UncommonModels/FemtoLCC/site/content/docs/_index.md

---
title: "Documentation"
---

Reference material for building, ordering and reproducing the FemtoLCC board.
