UncommonModels/FemtoLCC/production/render-bottom.png

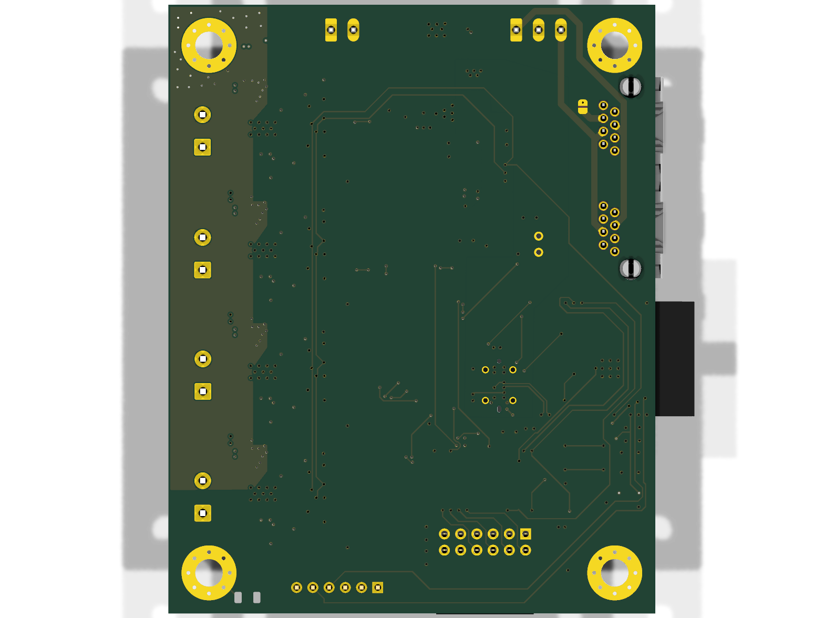
production/render-bottom.png
