UncommonModels/FemtoLCC/project_libraries/RJHSE508002/RJHSE508002.step

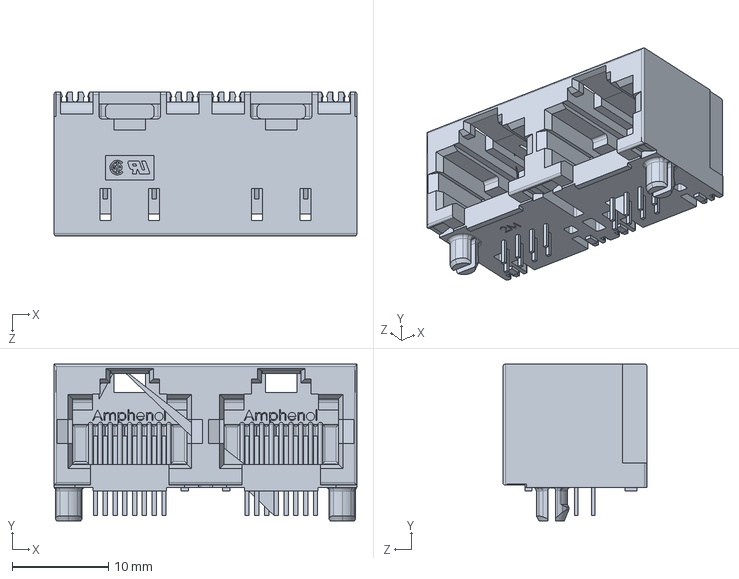
[picture p3: CAD file, 2026-04-15]
project_libraries/RJHSE508002/RJHSE508002.step
31.5 x 16.3 x 15.0 mm
