UncommonModels/FemtoLCC/project_libraries/ul_DRV8874PWPR/KiCADv6/PWP0016A.stp

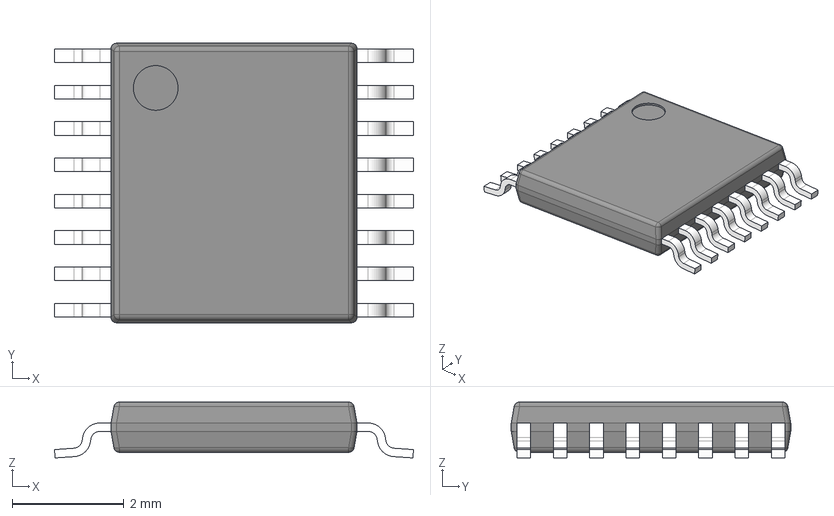
[picture p4: CAD file, 2025-12-02]
project_libraries/ul_DRV8874PWPR/KiCADv6/PWP0016A.stp
6.42 x 5.00 x 1.00 mm
BODY-SO
LEAD-SO x 16
THERMALPAD-SO
PIN1-ID
