UncommonModels/FemtoLCC/FemtoLCC.kicad_pcb

## KiCad design FemtoLCC.kicad_pcb (2026-09-06)

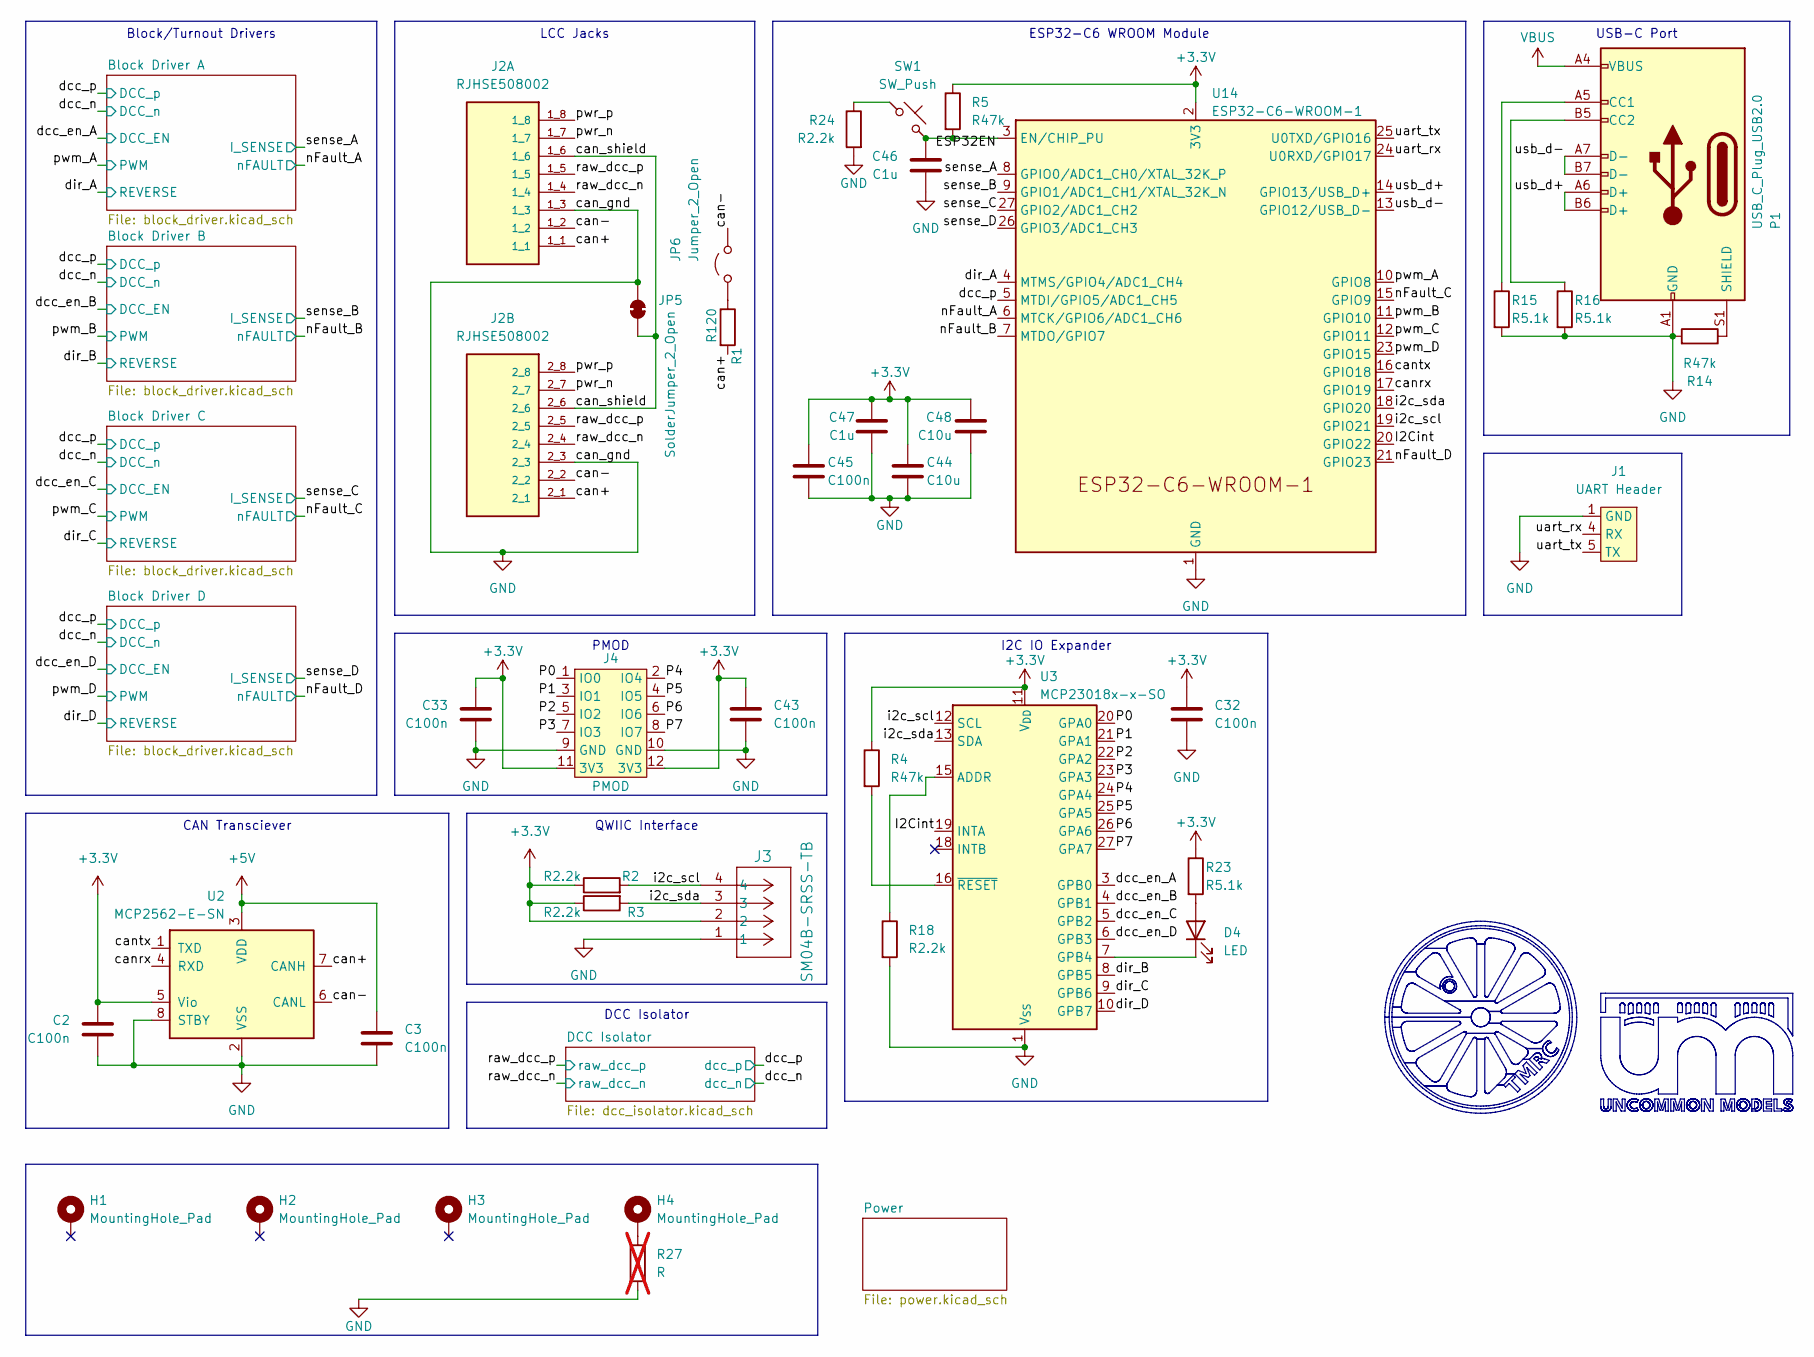
[picture p5: schematic FemtoLCC.kicad_sch, Femto LCC Booster]

Parts:
C2, C3, C32, C33, C43: C100n; C_0805_2012Metric_Pad1.18x1.45mm_HandSolder; Manufacturer Part Number CL21B104KACNFNC
C44, C48: C10u; C_1206_3216Metric_Pad1.33x1.80mm_HandSolder
C45: C100n; C_0805_2012Metric_Pad1.18x1.45mm_HandSolder
C46, C47: C1u; C_0805_2012Metric_Pad1.18x1.45mm_HandSolder
D4: LED; LED_0603_1608Metric
H1, H2, H3, H4: MountingHole_Pad; MountingHole_4.3mm_M4_Pad_Via
J1: UART Header; PinHeader_1x06_P2.54mm_Vertical
J2: RJHSE508002; AMPHENOL_RJHSE508002; PARTREV E
J3: SM04B-SRSS-TB; JST_SH_BM04B-SRSS-TB_1x04-1MP_P1.00mm_Vertical
J4: PMOD; PinSocket_2x06_P2.54mm_Horizontal
JP5: SolderJumper_2_Open; SolderJumper-2_P1.3mm_Bridged_RoundedPad1.0x1.5mm
JP6: Jumper_2_Open; TestPoint_2Pads_Pitch2.54mm_Drill0.8mm
P1: USB_C_Plug_USB2.0; USB_C_Receptacle_G-Switch_GT-USB-7051x
R1: R120; R_0805_2012Metric_Pad1.20x1.40mm_HandSolder; Manufacturer Part Number ERJ6ENF4702V
R2, R3, R18, R24: R2.2k; R_0402_1005Metric; Manufacturer Part Number ERJ6ENF4702V
R4: R47k; R_0805_2012Metric_Pad1.20x1.40mm_HandSolder; Manufacturer Part Number ERJ6ENF4702V
R5, R14: R47k; R_0402_1005Metric; Manufacturer Part Number ERJ6ENF4702V
R15, R16, R23: R5.1k; R_0402_1005Metric
R27: R; R_1206_3216Metric; not fitted
SW1: SW_Push; SW_Push_1P1T_XKB_TS-1187A
U2: MCP2562-E-SN; SOIC-8_3.9x4.9mm_P1.27mm; Manufacturer Part Number MCP2562-E-SN
U3: MCP23018x-x-SO; SOIC-28W_7.5x17.9mm_P1.27mm
U14: ESP32-C6-WROOM-1

Connections:
+3.3V: C2.1, C32.1, C33.1, C43.1, C44.1, C45.1, C47.2, C48.1, J3.2, J4.11 (3V3), J4.12 (3V3), R2.1, R3.1, R4.1, R5.1, R23.1, U2.5 (Vio), U3.11 (V_{DD}), U14.2 (3V3); also elsewhere on the board
+5V: C3.1, U2.3 (VDD); also elsewhere on the board
/ESP32EN: C46.2, R5.2, SW1.2, U14.3 (EN/CHIP_PU)
/I2Cint: U3.19 (INTA), U14.20 (GPIO22)
/P0: J4.1 (IO0), U3.20 (GPA0)
/P1: J4.3 (IO1), U3.21 (GPA1)
/P2: J4.5 (IO2), U3.22 (GPA2)
/P3: J4.7 (IO3), U3.23 (GPA3)
/P4: J4.2 (IO4), U3.24 (GPA4)
/P5: J4.4 (IO5), U3.25 (GPA5)
/P6: J4.6 (IO6), U3.26 (GPA6)
/P7: J4.8 (IO7), U3.27 (GPA7)
/can+: J2.1_1, J2.2_1, R1.2, U2.7 (CANH)
/can-: J2.1_2, J2.2_2, JP6.2 (B), U2.6 (CANL)
/can_shield: J2.1_6, J2.2_6, JP5.1 (A)
/canrx: U2.4 (RXD), U14.17 (GPIO19)
/cantx: U2.1 (TXD), U14.16 (GPIO18)
/dcc_en_A: U3.3 (GPB0); also elsewhere on the board
/dcc_en_B: U3.4 (GPB1); also elsewhere on the board
/dcc_en_C: U3.5 (GPB2); also elsewhere on the board
/dcc_en_D: U3.6 (GPB3); also elsewhere on the board
/dcc_p: U14.5 (MTDI/GPIO5/ADC1_CH5); also elsewhere on the board
/dir_A: U14.4 (MTMS/GPIO4/ADC1_CH4); also elsewhere on the board
/dir_B: U3.8 (GPB5); also elsewhere on the board
/dir_C: U3.9 (GPB6); also elsewhere on the board
/dir_D: U3.10 (GPB7); also elsewhere on the board
/i2c_scl: J3.4, R2.2, U3.12 (SCL), U14.19 (GPIO21)
/i2c_sda: J3.3, R3.2, U3.13 (SDA), U14.18 (GPIO20)
/nFault_A: U14.6 (MTCK/GPIO6/ADC1_CH6); also elsewhere on the board
/nFault_B: U14.7 (MTDO/GPIO7); also elsewhere on the board
/nFault_C: U14.15 (GPIO9); also elsewhere on the board
/nFault_D: U14.21 (GPIO23); also elsewhere on the board
/pwm_A: U14.10 (GPIO8); also elsewhere on the board
/pwm_B: U14.11 (GPIO10); also elsewhere on the board
/pwm_C: U14.12 (GPIO11); also elsewhere on the board
/pwm_D: U14.23 (GPIO15); also elsewhere on the board
/pwr_n: J2.1_7, J2.2_7
/pwr_p: J2.1_8, J2.2_8
/raw_dcc_n: J2.1_4, J2.2_4; also elsewhere on the board
/raw_dcc_p: J2.1_5, J2.2_5; also elsewhere on the board
/sense_A: U14.8 (GPIO0/ADC1_CH0/XTAL_32K_P); also elsewhere on the board
/sense_B: U14.9 (GPIO1/ADC1_CH1/XTAL_32K_N); also elsewhere on the board
/sense_C: U14.27 (GPIO2/ADC1_CH2); also elsewhere on the board
/sense_D: U14.26 (GPIO3/ADC1_CH3); also elsewhere on the board
/uart_rx: J1.4 (RX), U14.24 (U0RXD/GPIO17)
/uart_tx: J1.5 (TX), U14.25 (U0TXD/GPIO16)
/usb_d+: P1.A6 (D+), P1.B6 (D+), U14.14 (GPIO13/USB_D+)
/usb_d-: P1.A7 (D-), P1.B7 (D-), U14.13 (GPIO12/USB_D-)
GND: C2.2, C3.2, C32.2, C33.2, C43.2, C44.2, C45.2, C46.1, C47.1, C48.2, J1.1 (GND), J2.1_3, J2.2_3, J3.1, J4.9 (GND), J4.10 (GND), JP5.2 (B), P1.A1 (GND), P1.A12 (GND), P1.B1 (GND), P1.B12 (GND), R14.2, R15.2, R16.2, R18.2, R24.2, R27.2, U2.2 (VSS), U2.8 (STBY), U3.1 (V_{SS}), U14.1 (GND), U14.28 (GND), U14.29 (GND); also elsewhere on the board
unnamed: D4.2 (A), R23.2
unnamed: D4.1 (K), U3.7 (GPB4)
unnamed: H4.1 (1_1), R27.1
unnamed: JP6.1 (A), R1.1
unnamed: P1.A5 (CC1), R15.1
unnamed: P1.B5 (CC2), R16.1
unnamed: P1.S1 (SHIELD), R14.1
unnamed: R24.1, SW1.1
unnamed: R18.1, U3.15 (ADDR)
unnamed: R4.2, U3.16 (~RESET)
VBUS: P1.A4 (VBUS), P1.A9 (VBUS), P1.B4 (VBUS), P1.B9 (VBUS); also elsewhere on the board

Notes on the sheet:
PMOD
CAN Transciever
I2C IO Expander
Block/Turnout Drivers
DCC Isolator
USB-C Port
QWIIC Interface
LCC Jacks
ESP32-C6 WROOM Module

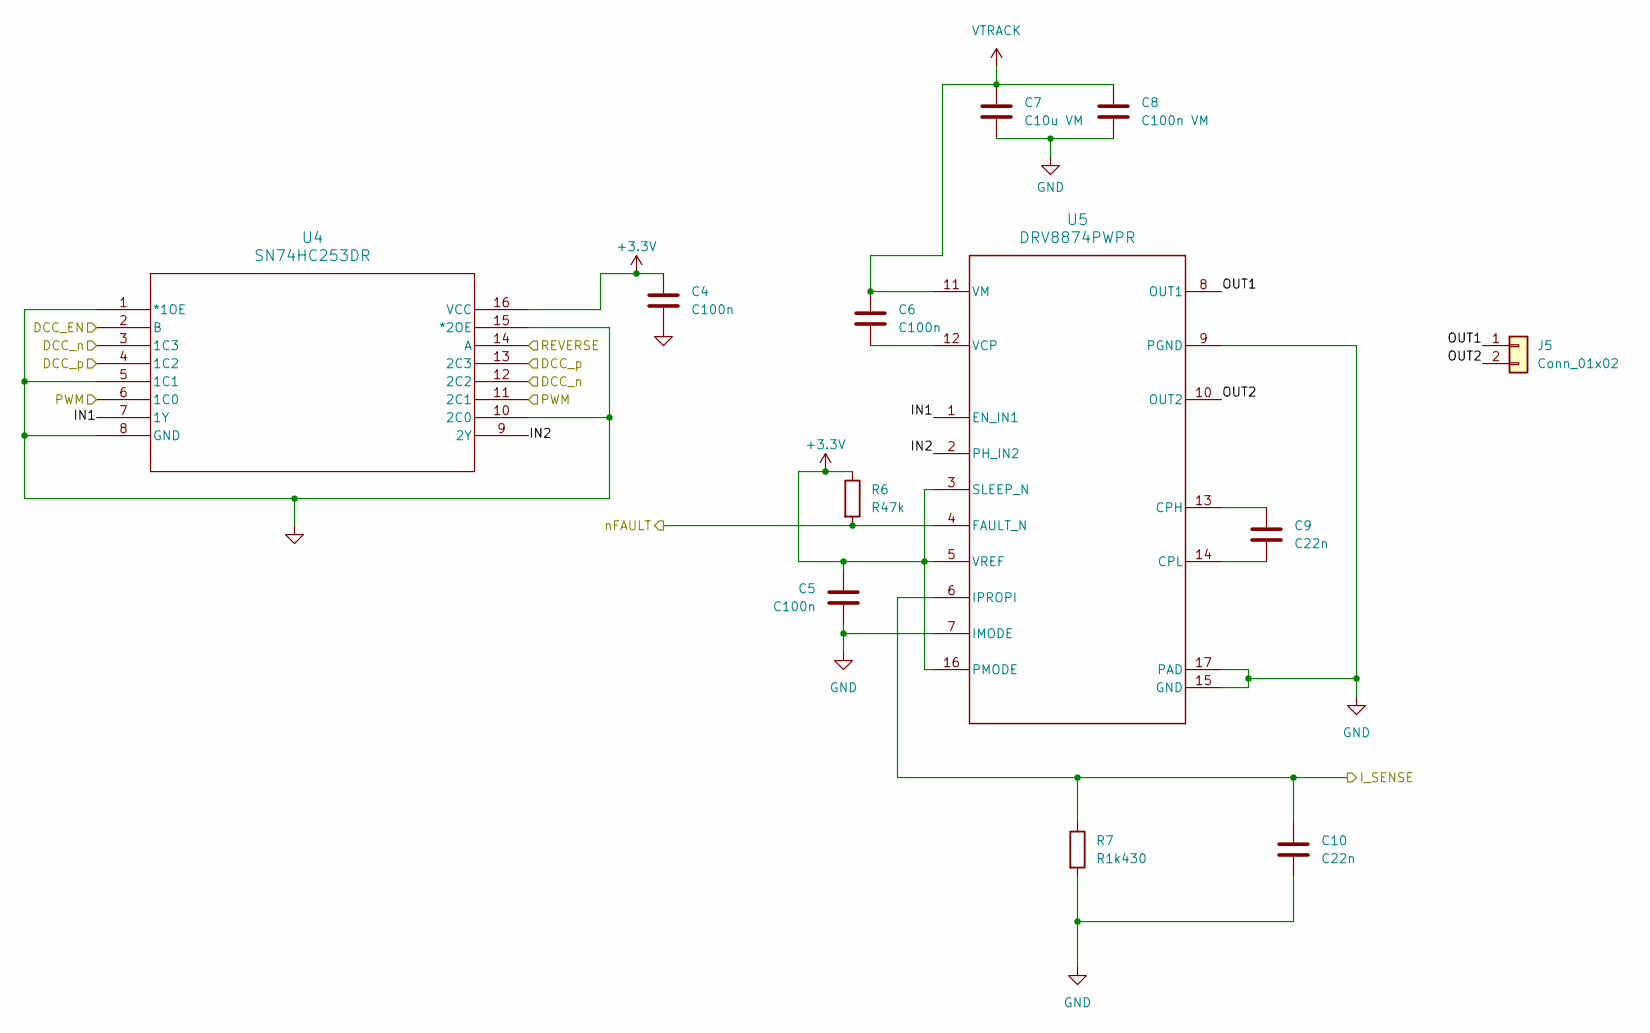
[picture p6: schematic block_driver.kicad_sch, Femto LCC Booster]

Parts:
C4, C5, C6: C100n; C_0805_2012Metric_Pad1.18x1.45mm_HandSolder; Manufacturer Part Number CL21B104KACNFNC
C7: C10u VM; C_1206_3216Metric_Pad1.33x1.80mm_HandSolder; Manufacturer Part Number CL31A106KBHNNNE
C8: C100n VM; C_0805_2012Metric_Pad1.18x1.45mm_HandSolder; Manufacturer Part Number CL21B104KBFXPJE
C9, C10: C22n; C_0805_2012Metric_Pad1.18x1.45mm_HandSolder; Manufacturer Part Number CL21B223JBANNNC
J5: Conn_01x02; TerminalBlock_Phoenix_MKDS-1,5-2-5.08_1x02_P5.08mm_Horizont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
R6: R47k; R_0805_2012Metric_Pad1.20x1.40mm_HandSolder; Manufacturer Part Number ERJ6ENF4702V
R7: R1k430; R_0805_2012Metric_Pad1.20x1.40mm_HandSolder; Manufacturer Part Number RC0805FR-071K43L
U4: SN74HC253DR; SO-16_3.9x9.9mm_P1.27mm; Manufacturer Part Number SN74HC253DR
U5: DRV8874PWPR; PWP0016J_NV; Manufacturer Part Number DRV8874PWPR

Connections:
+3.3V: C4.1, C5.1, R6.1, U4.16 (VCC), U5.3 (SLEEP_N), U5.5 (VREF), U5.16 (PMODE); also elsewhere on the board
/Block Driver A/IN1: U4.7 (1Y), U5.1 (EN_IN1)
/Block Driver A/IN2: U4.9 (2Y), U5.2 (PH_IN2)
/Block Driver A/OUT1: J5.1, U5.8 (OUT1)
/Block Driver A/OUT2: J5.2, U5.10 (OUT2)
/dcc_en_A: U4.2 (B); also elsewhere on the board
/dcc_n: U4.3 (1C3), U4.12 (2C2); also elsewhere on the board
/dcc_p: U4.4 (1C2), U4.13 (2C3); also elsewhere on the board
/dir_A: U4.14 (A); also elsewhere on the board
/nFault_A: R6.2, U5.4 (FAULT_N); also elsewhere on the board
/pwm_A: U4.6 (1C0), U4.11 (2C1); also elsewhere on the board
/sense_A: C10.1, R7.1, U5.6 (IPROPI); also elsewhere on the board
GND: C4.2, C5.2, C7.2, C8.2, C10.2, R7.2, U4.1 (*1OE), U4.5 (1C1), U4.8 (GND), U4.10 (2C0), U4.15 (*2OE), U5.7 (IMODE), U5.9 (PGND), U5.15 (GND), U5.17 (PAD); also elsewhere on the board
unnamed: C9.1, U5.13 (CPH)
unnamed: C9.2, U5.14 (CPL)
unnamed: C6.2, U5.12 (VCP)
VTRACK: C6.1, C7.1, C8.1, U5.11 (VM); also elsewhere on the board

Parts of its further copies:
C11, C12, C13, C18, C19, C20, C25, C26, C27: C100n; C_0805_2012Metric_Pad1.18x1.45mm_HandSolder; Manufacturer Part Number CL21B104KACNFNC
C14, C21, C28: C10u VM; C_1206_3216Metric_Pad1.33x1.80mm_HandSolder; Manufacturer Part Number CL31A106KBHNNNE
C15, C22, C29: C100n VM; C_0805_2012Metric_Pad1.18x1.45mm_HandSolder; Manufacturer Part Number CL21B104KBFXPJE
C16, C17, C23, C24, C30, C31: C22n; C_0805_2012Metric_Pad1.18x1.45mm_HandSolder; Manufacturer Part Number CL21B223JBANNNC
J6, J7, J8: Conn_01x02; TerminalBlock_Phoenix_MKDS-1,5-2-5.08_1x02_P5.08mm_Horizont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
R8, R10, R12: R47k; R_0805_2012Metric_Pad1.20x1.40mm_HandSolder; Manufacturer Part Number ERJ6ENF4702V
R9, R11, R13: R1k430; R_0805_2012Metric_Pad1.20x1.40mm_HandSolder; Manufacturer Part Number RC0805FR-071K43L
U6, U8, U10: SN74HC253DR; SO-16_3.9x9.9mm_P1.27mm; Manufacturer Part Number SN74HC253DR
U7, U9, U11: DRV8874PWPR; PWP0016J_NV; Manufacturer Part Number DRV8874PWPR

Connections of its further copies:
+3.3V: C11.1, C12.1, C18.1, C19.1, C25.1, C26.1, R8.1, R10.1, R12.1, U6.16 (VCC), U7.3 (SLEEP_N), U7.5 (VREF), U7.16 (PMODE), U8.16 (VCC), U9.3 (SLEEP_N), U9.5 (VREF), U9.16 (PMODE), U10.16 (VCC), U11.3 (SLEEP_N), U11.5 (VREF), U11.16 (PMODE); also elsewhere on the board
/Block Driver B/IN1: U6.7 (1Y), U7.1 (EN_IN1)
/Block Driver B/IN2: U6.9 (2Y), U7.2 (PH_IN2)
/Block Driver B/OUT1: J6.1, U7.8 (OUT1)
/Block Driver B/OUT2: J6.2, U7.10 (OUT2)
/Block Driver C/IN1: U8.7 (1Y), U9.1 (EN_IN1)
/Block Driver C/IN2: U8.9 (2Y), U9.2 (PH_IN2)
/Block Driver C/OUT1: J7.1, U9.8 (OUT1)
/Block Driver C/OUT2: J7.2, U9.10 (OUT2)
/Block Driver D/IN1: U10.7 (1Y), U11.1 (EN_IN1)
/Block Driver D/IN2: U10.9 (2Y), U11.2 (PH_IN2)
/Block Driver D/OUT1: J8.1, U11.8 (OUT1)
/Block Driver D/OUT2: J8.2, U11.10 (OUT2)
/dcc_en_B: U6.2 (B); also elsewhere on the board
/dcc_en_C: U8.2 (B); also elsewhere on the board
/dcc_en_D: U10.2 (B); also elsewhere on the board
/dcc_n: U6.3 (1C3), U6.12 (2C2), U8.3 (1C3), U8.12 (2C2), U10.3 (1C3), U10.12 (2C2); also elsewhere on the board
/dcc_p: U6.4 (1C2), U6.13 (2C3), U8.4 (1C2), U8.13 (2C3), U10.4 (1C2), U10.13 (2C3); also elsewhere on the board
/dir_B: U6.14 (A); also elsewhere on the board
/dir_C: U8.14 (A); also elsewhere on the board
/dir_D: U10.14 (A); also elsewhere on the board
/nFault_B: R8.2, U7.4 (FAULT_N); also elsewhere on the board
/nFault_C: R10.2, U9.4 (FAULT_N); also elsewhere on the board
/nFault_D: R12.2, U11.4 (FAULT_N); also elsewhere on the board
/pwm_B: U6.6 (1C0), U6.11 (2C1); also elsewhere on the board
/pwm_C: U8.6 (1C0), U8.11 (2C1); also elsewhere on the board
/pwm_D: U10.6 (1C0), U10.11 (2C1); also elsewhere on the board
/sense_B: C17.1, R9.1, U7.6 (IPROPI); also elsewhere on the board
/sense_C: C24.1, R11.1, U9.6 (IPROPI); also elsewhere on the board
/sense_D: C31.1, R13.1, U11.6 (IPROPI); also elsewhere on the board
GND: C11.2, C12.2, C14.2, C15.2, C17.2, C18.2, C19.2, C21.2, C22.2, C24.2, C25.2, C26.2, C28.2, C29.2, C31.2, R9.2, R11.2, R13.2, U6.1 (*1OE), U6.5 (1C1), U6.8 (GND), U6.10 (2C0), U6.15 (*2OE), U7.7 (IMODE), U7.9 (PGND), U7.15 (GND), U7.17 (PAD), U8.1 (*1OE), U8.5 (1C1), U8.8 (GND), U8.10 (2C0), U8.15 (*2OE), U9.7 (IMODE), U9.9 (PGND), U9.15 (GND), U9.17 (PAD), U10.1 (*1OE), U10.5 (1C1), U10.8 (GND), U10.10 (2C0), U10.15 (*2OE), U11.7 (IMODE), U11.9 (PGND), U11.15 (GND), U11.17 (PAD); also elsewhere on the board
unnamed: C16.1, U7.13 (CPH)
unnamed: C16.2, U7.14 (CPL)
unnamed: C13.2, U7.12 (VCP)
unnamed: C23.1, U9.13 (CPH)
unnamed: C23.2, U9.14 (CPL)
unnamed: C20.2, U9.12 (VCP)
unnamed: C30.1, U11.13 (CPH)
unnamed: C30.2, U11.14 (CPL)
unnamed: C27.2, U11.12 (VCP)
VTRACK: C13.1, C14.1, C15.1, C20.1, C21.1, C22.1, C27.1, C28.1, C29.1, U7.11 (VM), U9.11 (VM), U11.11 (VM); also elsewhere on the board

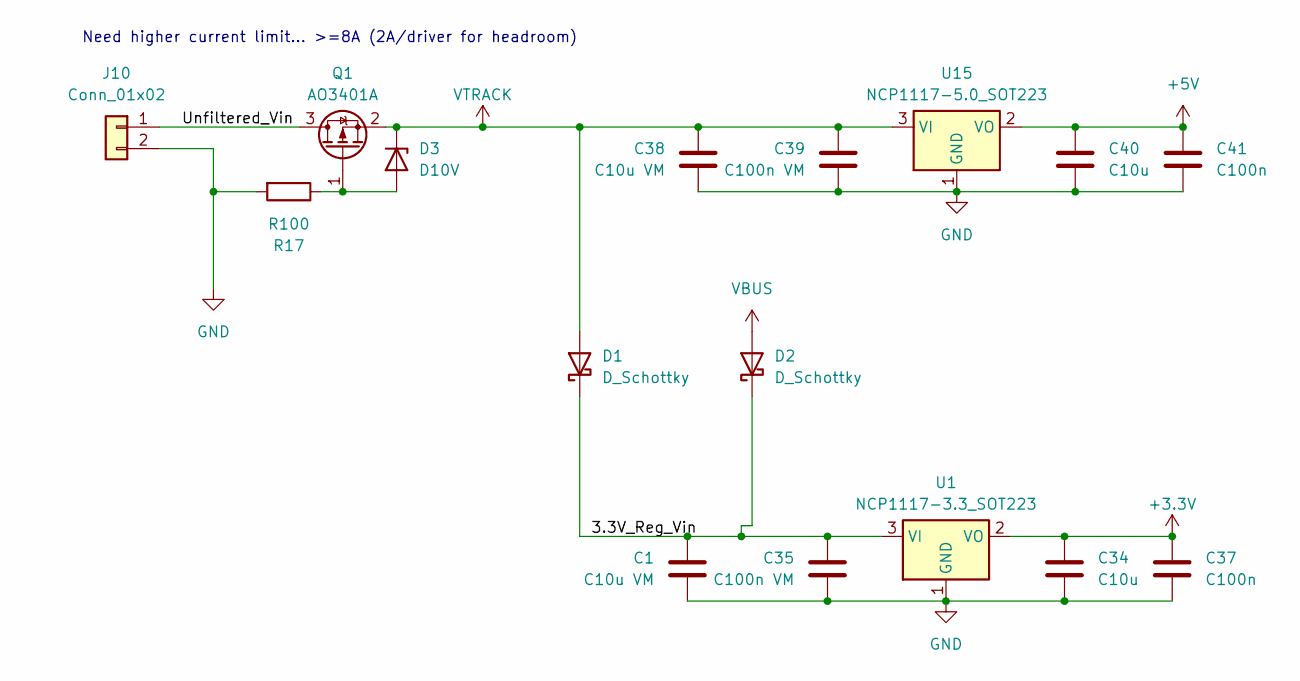
[picture p7: schematic power.kicad_sch, Femto LCC Booster]

Parts:
C1, C38: C10u VM; C_1206_3216Metric_Pad1.33x1.80mm_HandSolder
C34, C40: C10u; C_1206_3216Metric_Pad1.33x1.80mm_HandSolder
C35, C39: C100n VM; C_0805_2012Metric_Pad1.18x1.45mm_HandSolder
C37, C41: C100n; C_0805_2012Metric_Pad1.18x1.45mm_HandSolder
D1, D2: D_Schottky; D_SMA_Handsoldering
D3: D10V; D_SOD-323_HandSoldering
J10: Conn_01x02; PhoenixContact_MCV_1,5_2-G-3.5_1x02_P3.50mm_Vertical
Q1: AO3401A; SOT-23
R17: R100; R_0402_1005Metric
U1: NCP1117-3.3_SOT223; SOT-223-3_TabPin2
U15: NCP1117-5.0_SOT223; SOT-223-3_TabPin2

Connections:
+3.3V: C34.1, C37.1, U1.2 (VO); also elsewhere on the board
+5V: C40.1, C41.1, U15.2 (VO); also elsewhere on the board
/Power/3.3V_Reg_Vin: C1.1, C35.1, D1.1 (K), D2.1 (K), U1.3 (VI)
/Power/Unfiltered_Vin: J10.1, Q1.3 (D)
GND: C1.2, C34.2, C35.2, C37.2, C38.2, C39.2, C40.2, C41.2, J10.2, R17.2, U1.1 (GND), U15.1 (GND); also elsewhere on the board
unnamed: D3.2 (A), Q1.1 (G), R17.1
VBUS: D2.2 (A); also elsewhere on the board
VTRACK: C38.1, C39.1, D1.2 (A), D3.1 (K), Q1.2 (S), U15.3 (VI); also elsewhere on the board

Notes on the sheet:
Need higher current limit... >=8A (2A/driver for headroom)

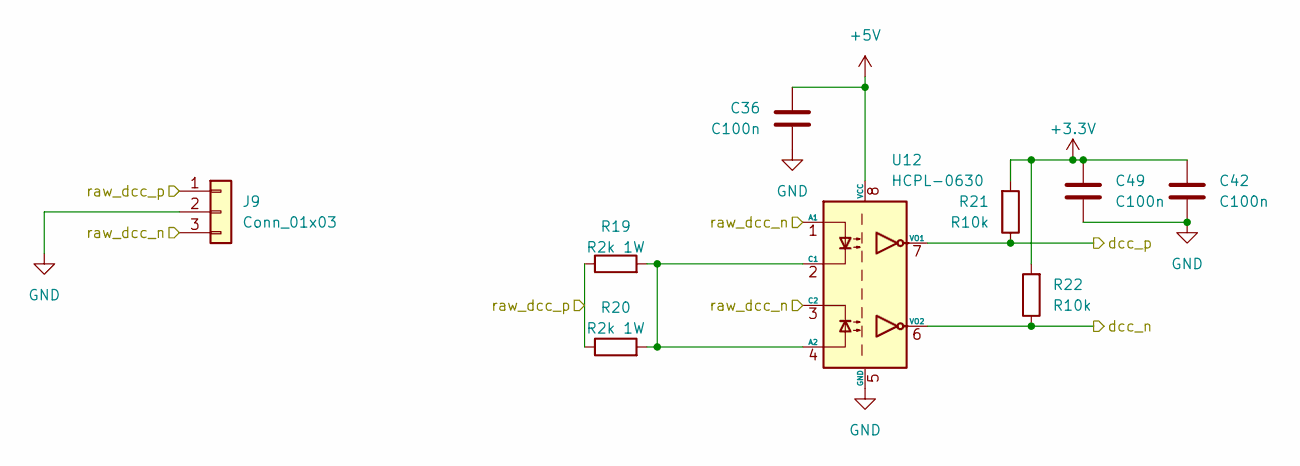
[picture p8: schematic dcc_isolator.kicad_sch, Femto LCC Booster]

Parts:
C36, C42, C49: C100n; C_0805_2012Metric_Pad1.18x1.45mm_HandSolder; Manufacturer Part Number CL21B104KACNFNC
J9: Conn_01x03; PhoenixContact_MCV_1,5_3-G-3.5_1x03_P3.50mm_Vertical
R19, R20: R2k 1W; R_2512_6332Metric_Pad1.40x3.35mm_HandSolder; Manufacturer Part Number AC2512JK-072KL
R21, R22: R10k; R_0805_2012Metric_Pad1.20x1.40mm_HandSolder; Manufacturer Part Number RC0805JR-0710KL
U12: HCPL-0630; SOIC-8_3.9x4.9mm_P1.27mm

Connections:
+3.3V: C42.1, C49.1, R21.2, R22.2; also elsewhere on the board
+5V: C36.1, U12.8 (VCC); also elsewhere on the board
/dcc_n: R22.1, U12.6 (VO2); also elsewhere on the board
/dcc_p: R21.1, U12.7 (VO1); also elsewhere on the board
/raw_dcc_n: J9.3, U12.1 (A1), U12.3 (C2); also elsewhere on the board
/raw_dcc_p: J9.1, R19.1, R20.1; also elsewhere on the board
GND: C36.2, C42.2, C49.2, J9.2, U12.5 (GND); also elsewhere on the board
unnamed: R19.2, R20.2, U12.2 (C1), U12.4 (A2)

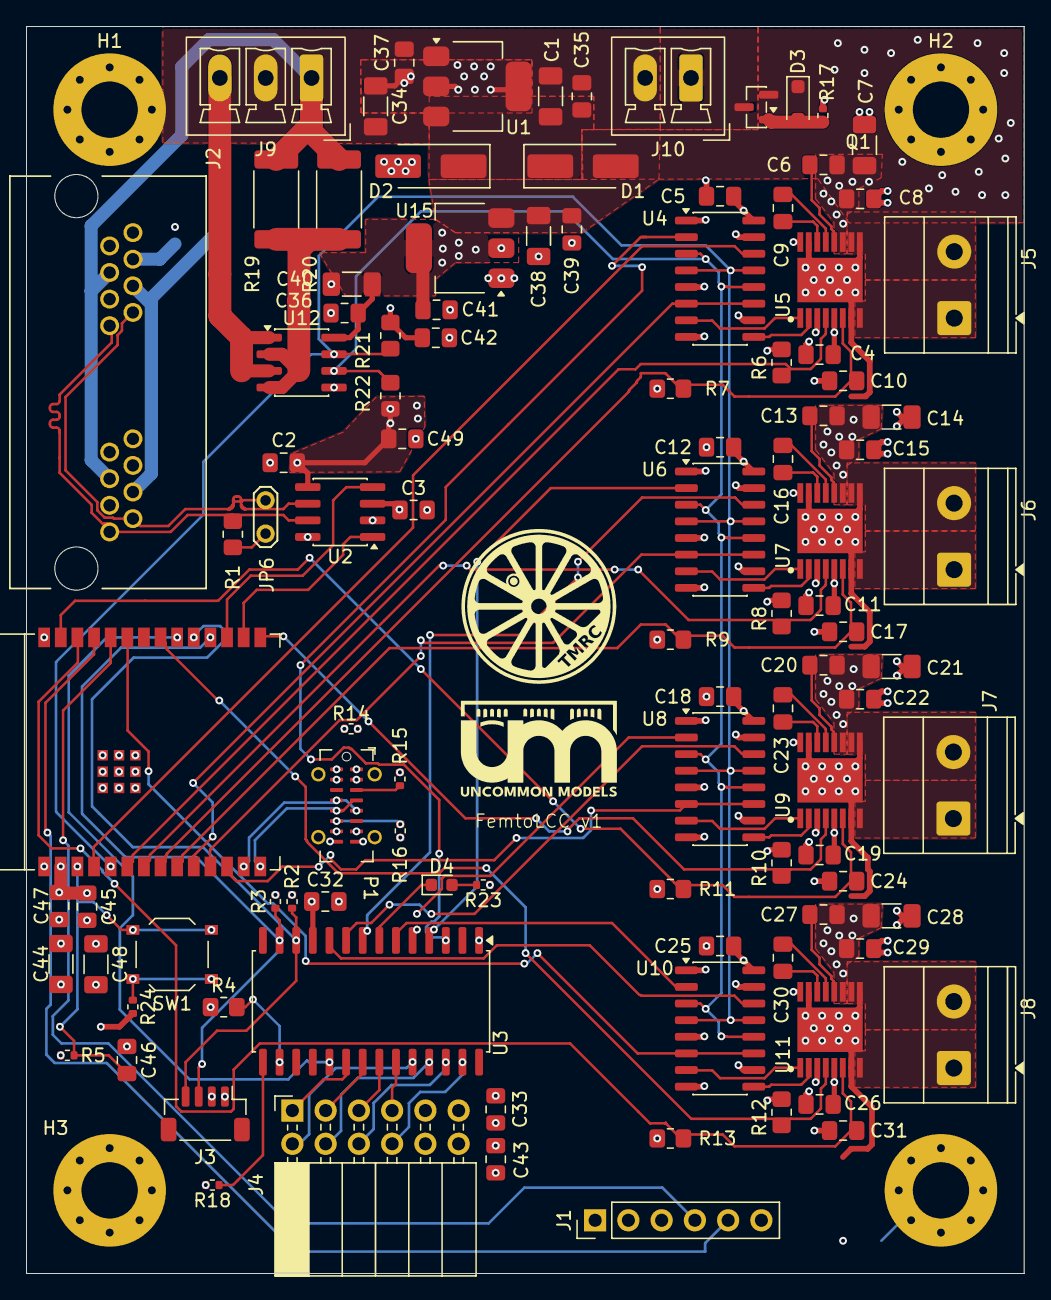
[picture p9: board FemtoLCC.kicad_pcb from above]

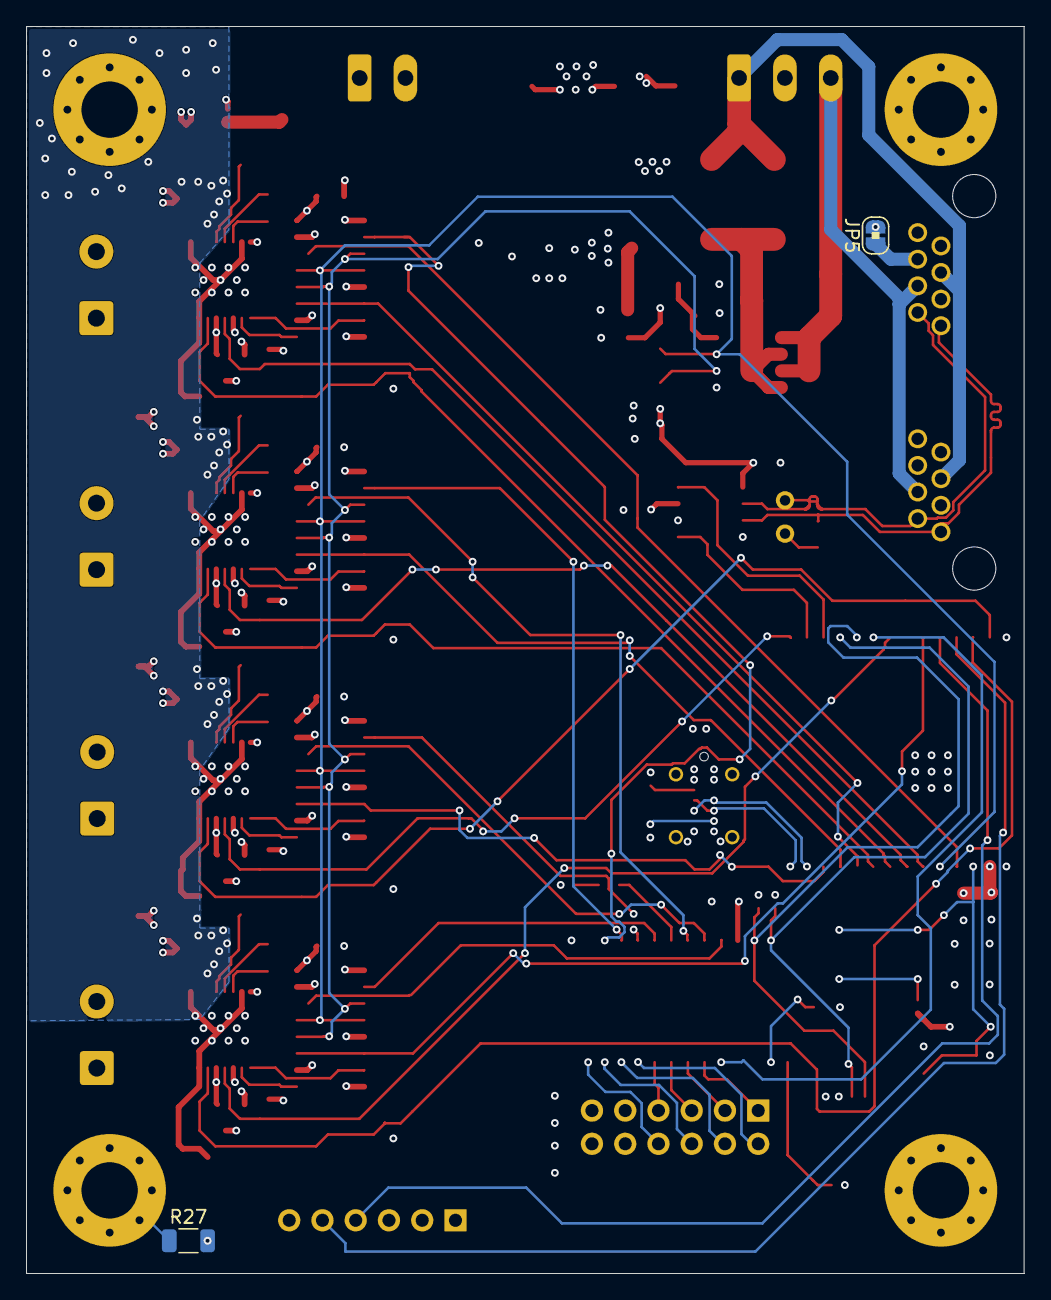
[picture p10: board FemtoLCC.kicad_pcb from below]

Board: 4 copper layers, 76.2 x 95.2 mm, 111 parts (2 on the bottom side), 94 nets.
