UncommonModels/FemtoLCC/(commit log)

2026-04-15 Add new routing strategy
    [FemtoLCC.kicad_pcb, FemtoLCC.kicad_sch, RJHSE508002.step, block_driver.kicad_sch, dcc_isolator.kicad_sch, power.kicad_sch]
2026-09-06 Add fab pipeline, firmware, docs site, and tooling
    - Makefile: kicad-cli gerber/drill/BOM/CPL/render exports, ERC/DRC, Hugo
    docs build, and firmware delegation to software/Makefile
    - software/: ESP32-C6 Arduino firmware (channels, DCC source, expander,
    LCC traction, occupancy, throttle)
    - site/: Hugo documentation site with GitHub Pages workflow
    - tools/: BOM/CPL to JLCPCB converters, LCSC part map, stock checker
    - production/: gerber bundle, board renders, ordering README
    - .gitignore: firmware build output, __pycache__, upload staging,
    Hugo output, ERC/DRC reports; un-ignore tools/lcsc-parts.csv
    - KiCad board, schematic, and DRV8874 footprint updates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
    [FemtoLCC-B_Cu.gbl, FemtoLCC-B_Mask.gbs, FemtoLCC-B_Paste.gbp, FemtoLCC-B_Silkscreen.gbo, FemtoLCC-Edge_Cuts.gm1, FemtoLCC-F_Cu.gtl, FemtoLCC-F_Mask.gts, FemtoLCC-F_Paste.gtp]
2026-09-06 Fix product name in schematic title blocks
    The title block on all four sheets read "Femto LCC Booster" with a space,
    against "FemtoLCC" everywhere else including the silkscreen. Title text
    only; no change to symbols, nets or connectivity.
    [FemtoLCC.kicad_sch, block_driver.kicad_sch, dcc_isolator.kicad_sch, power.kicad_sch]
2026-09-06 Adopt the shared Uncommon Models brand layer in the docs
    Link css/brand.css from the org site for the palette, title bar, buttons and
    card surface, and drop the copies that had been maintained by hand here - the
    Contact button had already drifted (Bootstrap contributes line-height 1.5 on
    the brand site, this site inherited 1.6).
    The header now carries the Uncommon Models logo beside the FemtoLCC wordmark,
    matching the brand site's title bar. Running text is held to a 70ch measure;
    tables, code blocks and figures stay full width.
    The brand stylesheet URL is a site param, so local work can point at an
    unreleased copy:
    HUGO_PARAMS_BRANDCSS=http://127.0.0.1:4000/css/brand.css hugo server
    Co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
2026-09-16 Add v1 errata, fit R5, and refresh the production counts
    R5 was left off the do-not-populate list, so the first boards came
    without it and had to be jumped with solder. It is fitted from now on,
    and the assembly counts in the production docs are regenerated: 102
    placements, with J1, J2 and JP6 hand-fitted.
    The new errata page records the R5 fix for boards already built, and the
    docs menu gains Configuration and Errata.
2026-09-16 Firmware 0.3.0: live control, module storage, Qwiic boards, pulsed detection
    The board can now be driven by a dispatcher and built into a modular
    layout, and it reports occupancy on blocks that have no power.
    Live control (memory space 0xE0) sets each output's mode, direction and
    DC speed moment to moment, starts the DCC source and commands
    locomotives on it. Nothing is saved, and a lease switches everything off
    if the dispatcher goes quiet, so a crash cannot leave trains running.
    Module storage (0xE1) keeps this module's part of a track plan, up to
    16 KB of text, in the flash area the partition table sets aside for a
    file system. olcbweb assembles a layout from the modules on the bus.
    Qw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
    [Channels.cpp, Channels.h, Config.h, Expander.cpp, Expander.h, I2cBus.cpp, I2cBus.h, IoBoards.cpp]
2026-09-16 Add an alternative firmware built on OpenMRN
    A second firmware for the same board, as an ESP-IDF project with full
    OpenMRN as a component: the reference implementation of the standards,
    where the other firmware is our own stack.
    It builds for the ESP32-C6, which OpenMRN did not support. Four small
    patches are kept in patches/ and applied to a private copy, never to the
    OpenMRN checkout: a C6 branch in macros.h, the renamed TWAI registers on
    a chip with two CAN controllers (written to be correct everywhere), the
    missing C6 entry in the chip-info table, and a FreeRTOS config clash that
    breaks on any target with ESP-IDF 5.x.
    The hardware drivers are byte-identical copies of the other firmware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
    [Arduino.h, Channels.cpp, Channels.h, Config.h, Expander.cpp, Expander.h, IoPins.cpp, IoPins.h]
2026-09-16 Ignore the OpenMRN C6 porting notes
    UPSTREAM-C6.md collects what OpenMRN upstream needs for the ESP32-C6, as
    a working note alongside the patches themselves. It is not a deliverable,
    so it stays out of the repository.
2026-09-18 One firmware: OpenMRN, built against a pinned submodule
    The board had two firmwares — an Arduino sketch on our own AOLCB
    library, and an ESP-IDF project on full OpenMRN. Only OpenMRN remains.
    software/ now contains one thing.
    OpenMRN is a git submodule pinned at bd82a644 instead of a path to
    whatever happened to be in a local checkout. That checkout moved and
    broke the build in two places at once, neither of them our code, which
    is the argument for pinning in one event: an override does not add to
    upstream, it replaces it, so every override is a promise about a
    specific revision. The patches are re-based against the pin — one
    retired because upstream fixed it, one added that the pin exp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
    [Arduino.h, Channels.cpp, Channels.h, Config.h, DCCSource.cpp, DCCSource.h, Expander.cpp, Expander.h]
